sloboste/rcCar/docs/images/topView_1.jpg

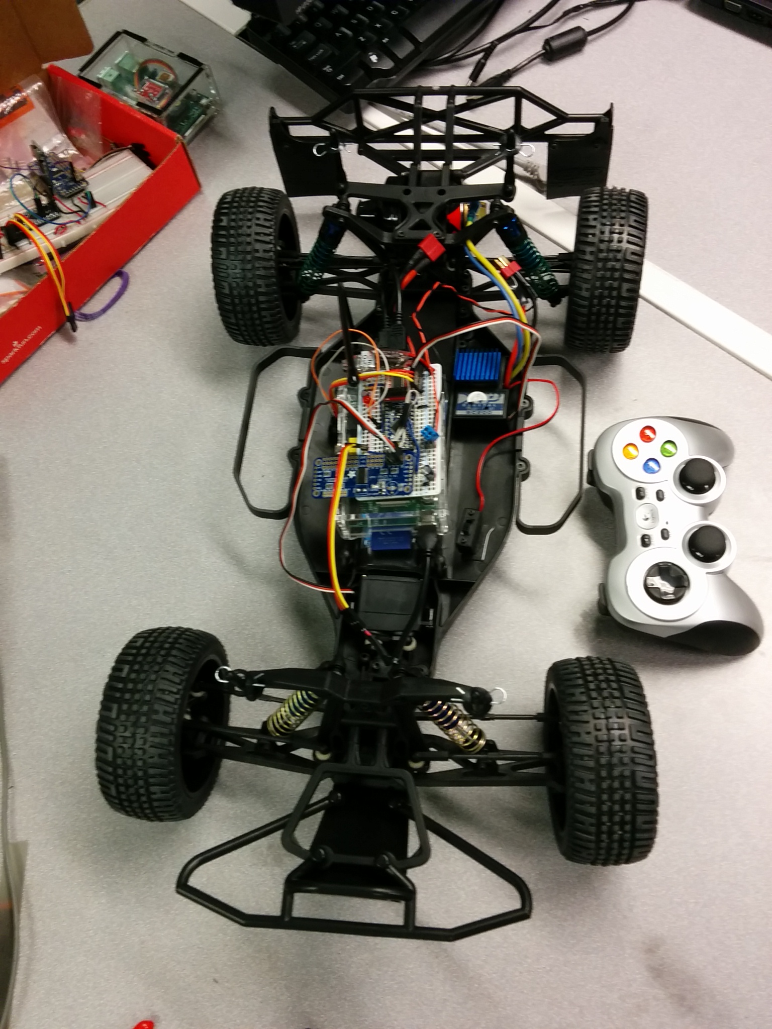
docs/images/topView_1.jpg
