sloboste/rcCar/docs/images/board_0.jpg

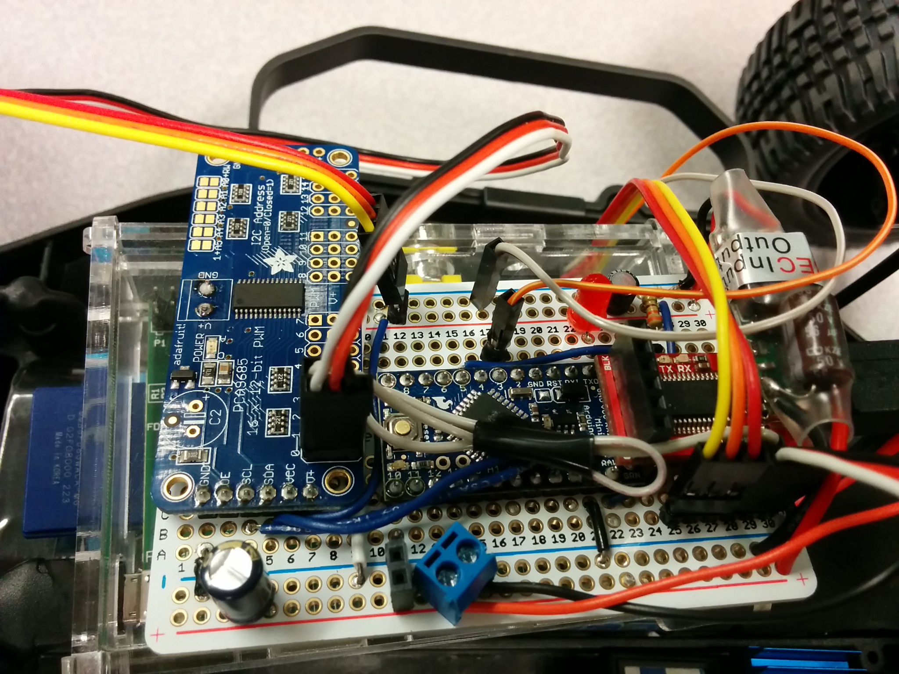
docs/images/board_0.jpg
