sloboste/rcCar/README.txt

Repository for the Microcomputer-Controlled Car project.
Contributors: Steven Sloboda

Full documentation is avaliable in docs/

Demo videos
Gamepad Control 0: http://youtu.be/MGlPLroegmY
