sloboste/rcCar/docs/images/board_1.jpg

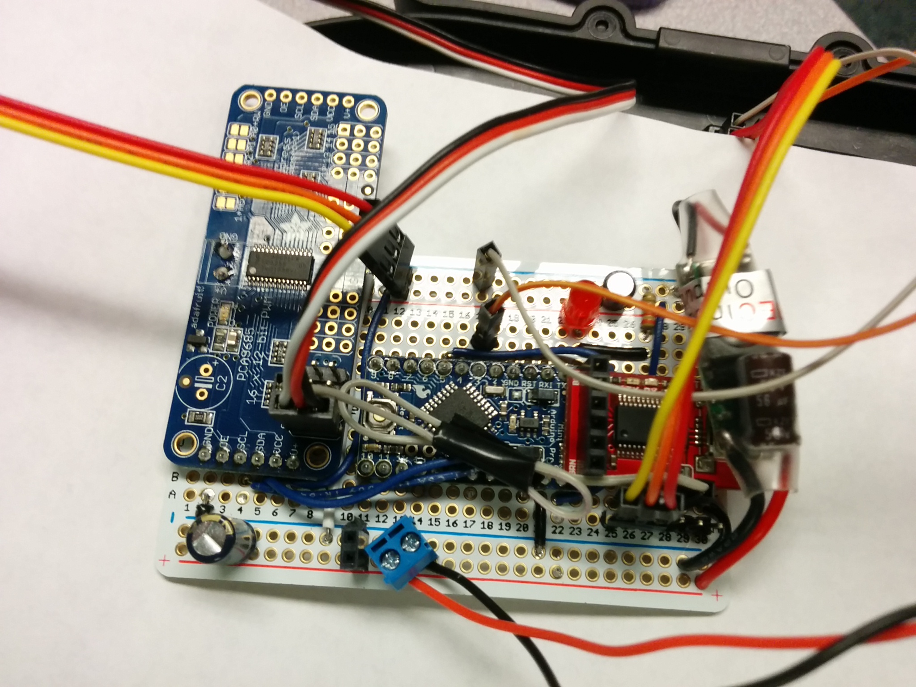
docs/images/board_1.jpg
