sloboste/rcCar/docs/images/board_2.jpg

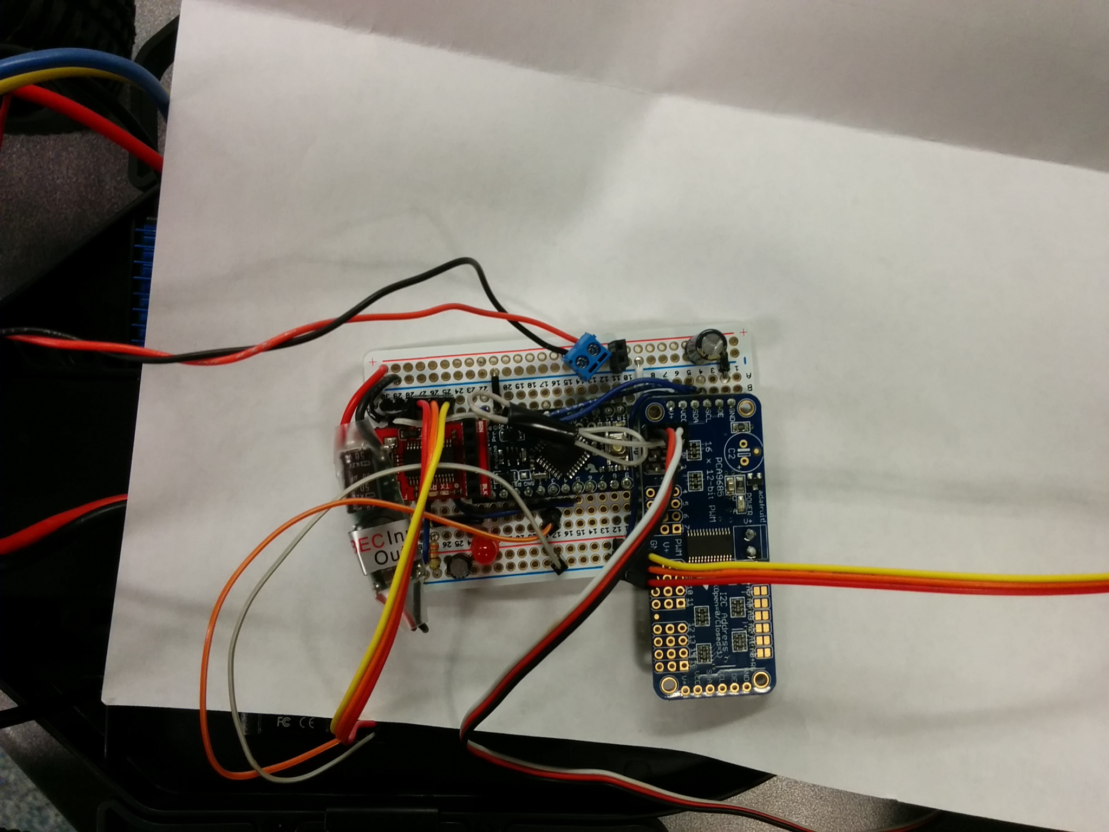
docs/images/board_2.jpg
