sloboste/rcCar/docs/images/breadboard_0.jpg

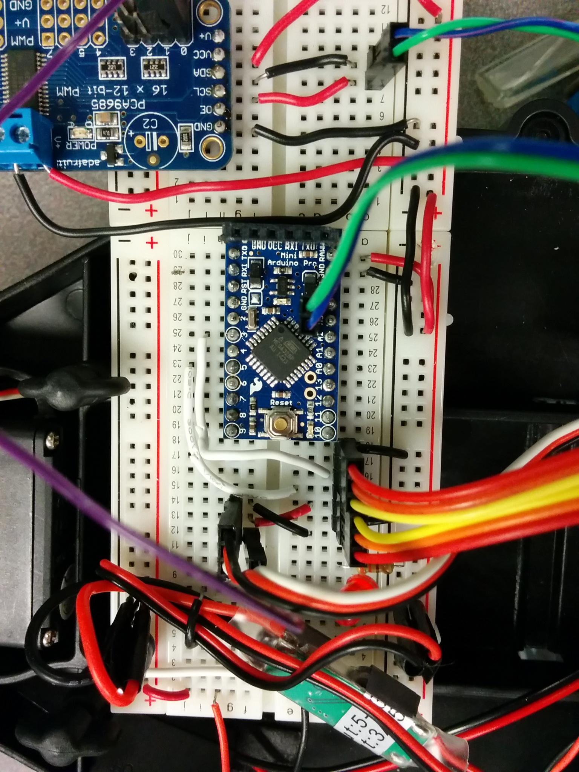
docs/images/breadboard_0.jpg
