sloboste/rcCar/docs/images/circuitry.png

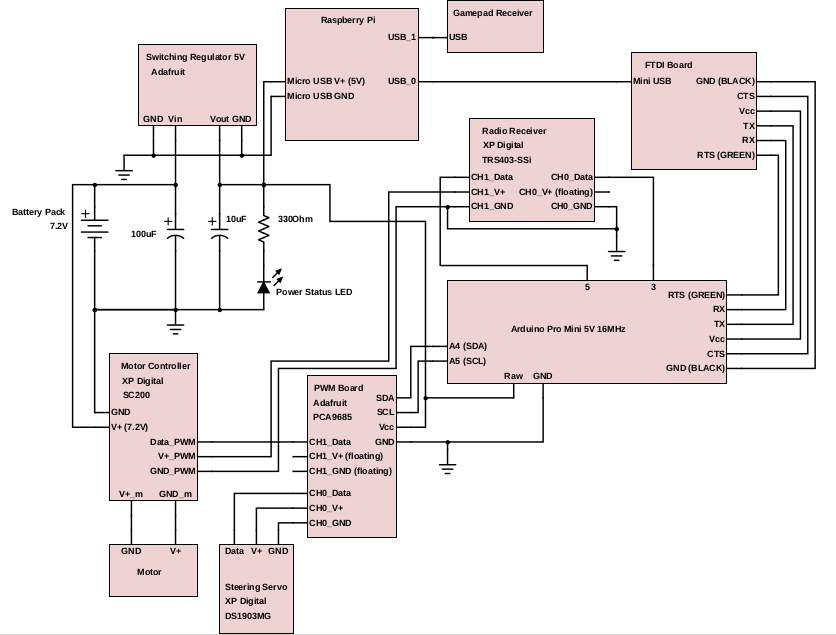
docs/images/circuitry.png
