sloboste/rcCar/docs/images/powerCircuitry.png

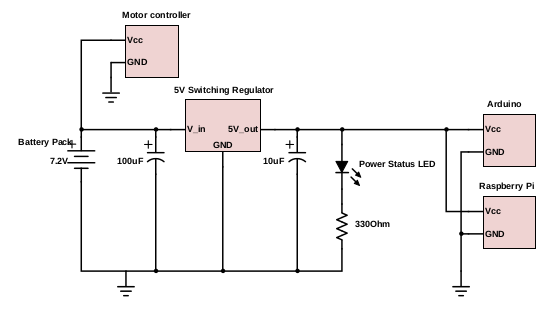
docs/images/powerCircuitry.png
