sloboste/rcCar/docs/images/sideView_0.jpg

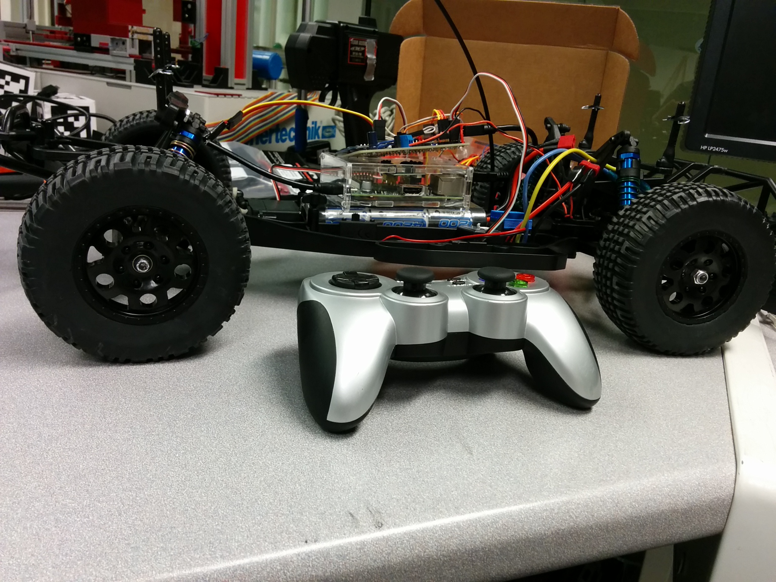
docs/images/sideView_0.jpg
