sloboste/rcCar/docs/images/sideView_1.jpg

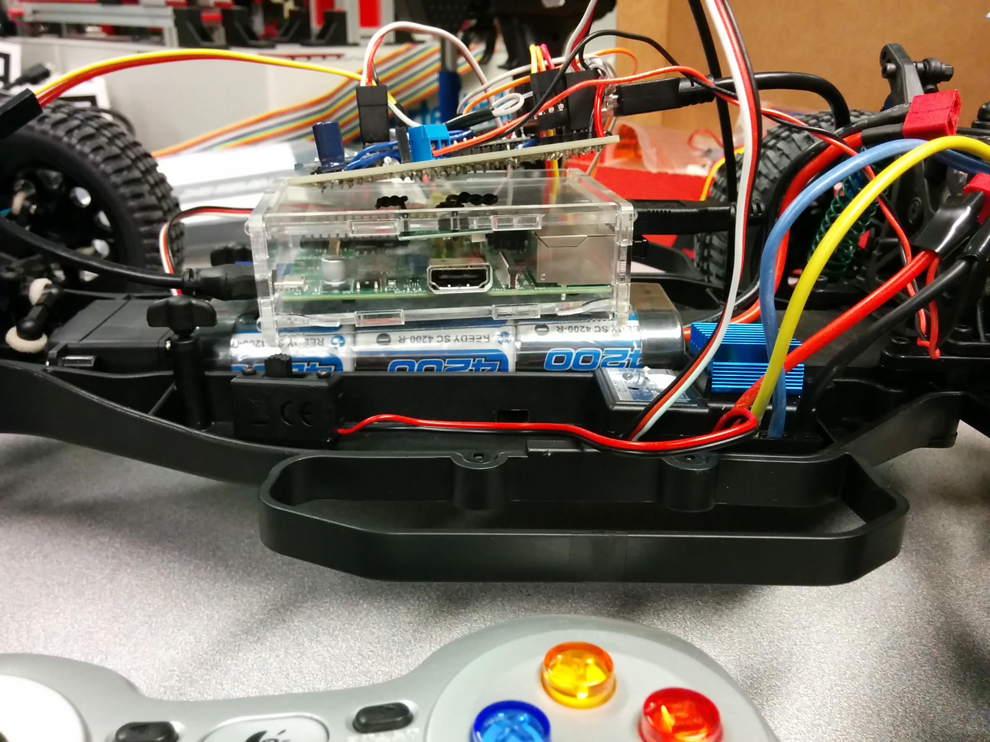
docs/images/sideView_1.jpg
