sloboste/rcCar/docs/images/sideView_2.jpg

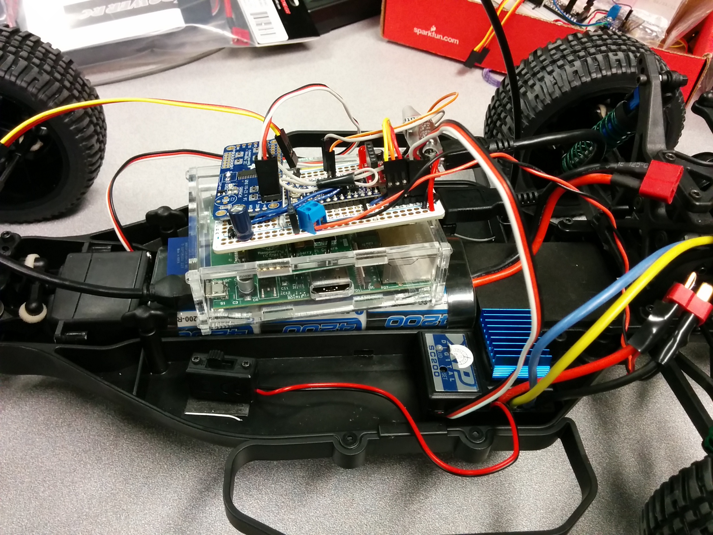
docs/images/sideView_2.jpg
