sloboste/rcCar/docs/images/topView_0.jpg

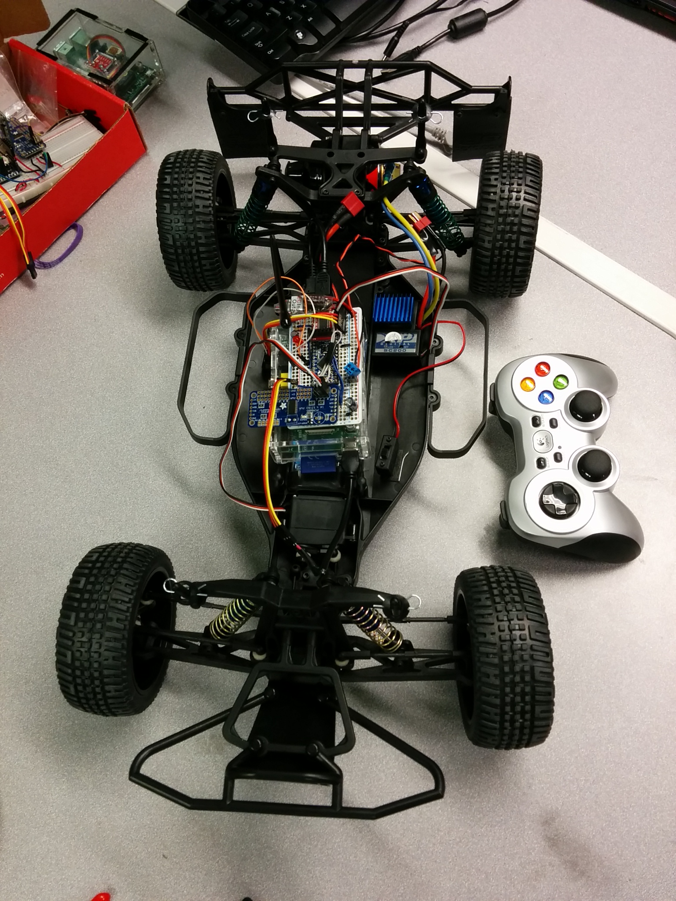
docs/images/topView_0.jpg
