sloboste/rcCar/docs/images/topView_2.jpg

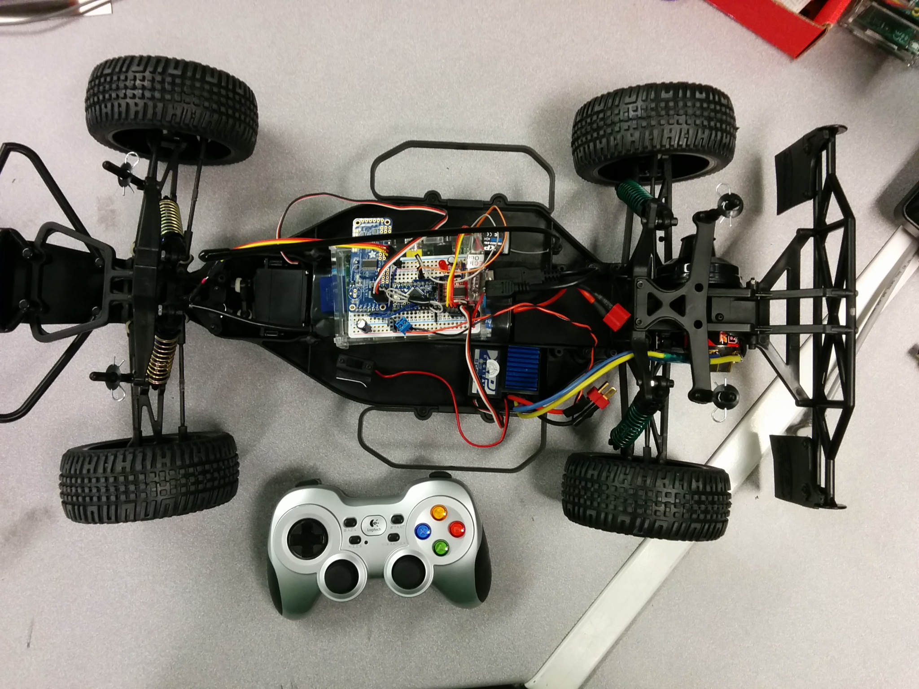
docs/images/topView_2.jpg
