sloboste/rcCar/docs/images/topView_3.jpg

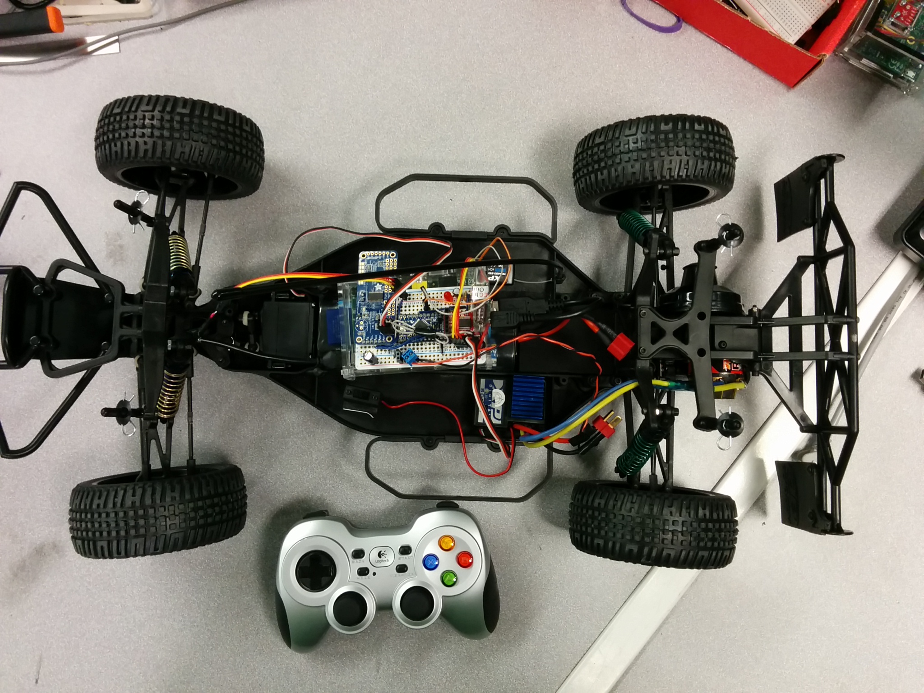
docs/images/topView_3.jpg
