sloboste/rcCar/docs/images/circuitry.pdf

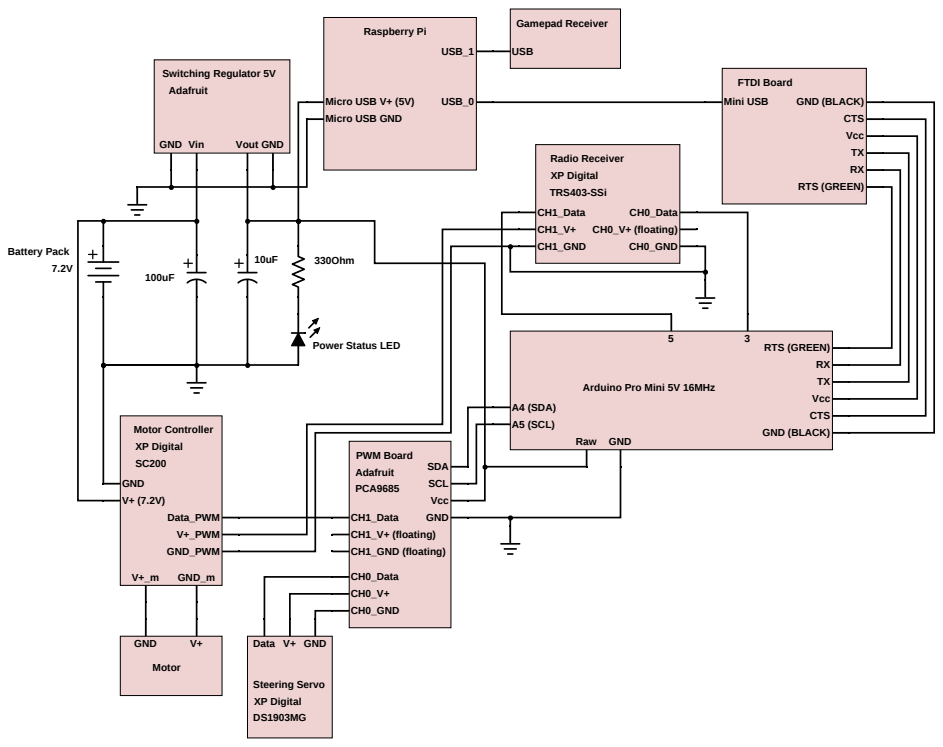
[picture p14: page 1]
Battery Pack; 330Ohm; GND; Motor; Radio Receiver; XP Digital; TRS403-SSi; CH1_Data; CH1_GND; CH0_Data; CH0_V+ (floating); CH0_GND; PCA9685; PWM Board; Adafruit; CH1_V+ (floating); CH1_GND (floating); SDA; SCL; Vcc; RTS (GREEN); CTS; GND (BLACK); A5 (SCL); A4 (SDA); Raw GND; Motor Controller; GND_m; V+_PWM; Data_PWM; GND_PWM; Data V+ GND; Steering Servo; Mini USB; FTDI Board; Switching Regulator 5V; GND Vin; Vout GND; Raspberry Pi; USB_1; USB_0; Gamepad Receiver; USB

Micro USB V+ (5V)
Micro USB GND

Power Status LED

Arduino Pro Mini 5V 16MHz
