sloboste/rcCar/docs/images/PowerCircuitry.pdf

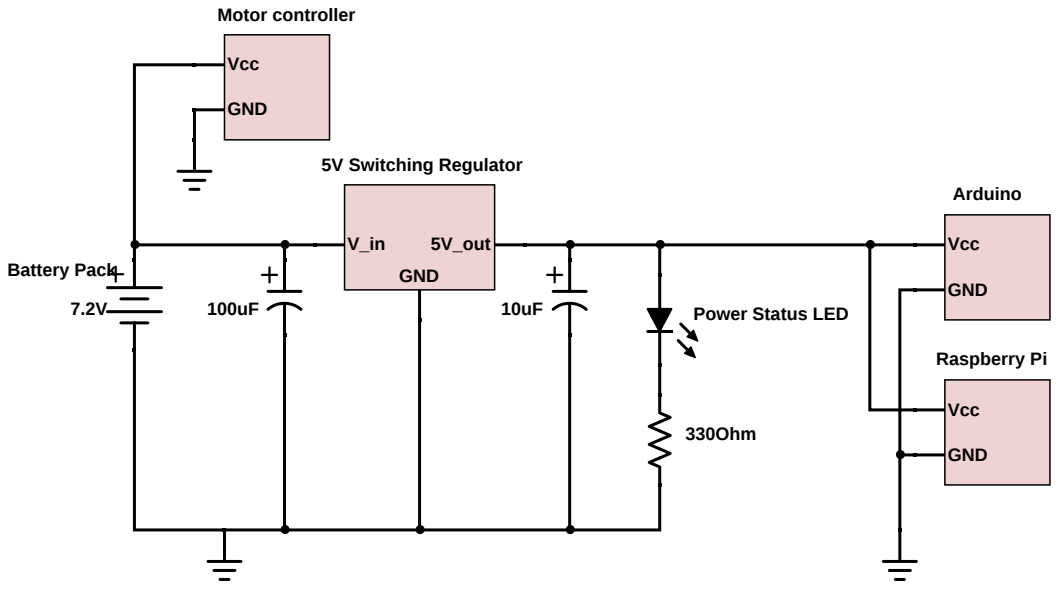
[picture p15: page 1]
330Ohm; Power Status LED; 5V_out; 5V Switching Regulator; GND; Motor controller; Vcc; Raspberry Pi; Arduino; Battery Pack
