sloboste/rcCar/(commit log)

2015-02-11 Worked on arduino code
2015-02-16 changed directory structure to keep arduino ide happy
2015-02-18 Need to test i2c communication
2015-02-23 Hardware pwm on atmega168 sucks. Use timer interrupts and software
2015-03-18 Arduino code almost done. Using the pwm module to connected to the arduino
2015-03-18 pin assignments
2015-03-25 Currently debugging code
2015-04-02 Worked on docs, arduino program.
2015-04-08 nearly full arduino control
2015-04-15 works! Need to clean up and fix docs
    [arduinoPWM.ino, car.py]
2015-04-22 working on data log. Arduino still can't properly send data
    [templog.csv]
2015-04-23 need to test arduino serial send, python data logging
2015-04-23 Basic plotting works
    [templog.csv]
2015-04-23 Serial works, logging works, plotter is buggy.
    [examplelog.csv, xlog.csv]
2015-04-23 plotting works
    [examplelog.csv]
2015-04-29 gamepad control works
    [examplelog.csv, xlog.csv]
2015-04-30 Something wrong on RPi. Can't control car from executable script...
    [gamepadControl.py]
2015-04-30 Fixed the RPi bug
    [pilog.csv]
2015-05-01 Adding images/videos
    [examplelog.csv, pilog.csv]
